douglasgoodwin/PennAnomaloscope/Electronics/PartsList_UKversion-2026-05-10.xlsx

Company | UK Stockist | Product | SKU | UK link | Notes | Item | Items in pack | Packs per anomaloscope | Cost per Item | Cost per Number of Arduinos
 |  |  |  |  |  |  |  |  |  | 1 | 2 | 3 | 4 | 5 | 6 | 7 | 8 | 9 | 10
Adafruit | thepihut.com | Diffused RGB (tri-color) 10mm LED (10 / order) | ADA848 | https://thepihut.com/products/diffused-rgb-tri-color-10mm-led-10-pack | appears to be same product | RGB LED | 10 | 0.1 | £9.60 | £9.60 | £9.60 | £9.60 | £9.60 | £9.60 | £9.60 | £9.60 | £9.60 | £9.60 | £9.60
Adafruit | thepihut.com | Diffused Yellow 10mm LED (25 / order) | ADA4204 | https://thepihut.com/products/diffused-10mm-led-pack-5-leds-each-in-5-colors-25-pack | Original product discontinued, this 25 pack incudes a good yellow | yellow LED | 25 (5x5 colours) | 0.2 | £7.70 | £7.70 | £7.70 | £7.70 | £7.70 | £7.70 | £15.40 | £15.40 | £15.40 | £15.40 | £15.40
3DQF | thepihut.com | Prusament ASA Natural 850g | PLA-009 | https://thepihut.com/products/jet-black-pla-filament-1-75mm-1kg | black filament instead | filament | 1kg | 0.1 | £18.00 | £18.00 | £18.00 | £18.00 | £18.00 | £18.00 | £18.00 | £18.00 | £18.00 | £18.00 | £18.00
Arduino | thepihut.com | Arduino Leonardo with Headers | A000057 | https://thepihut.com/products/arduino-leonardo-with-headers | same leonardo available | Leonardo | 1 | 1 | £21.20 | £21.20 | £42.40 | £63.60 | £84.80 | £106.00 | £127.20 | £148.40 | £169.60 | £190.80 | £212.00
The Pi Hut | thepihut.com | 330 Ω resistor (quarter and half watt sets) | 105395 | https://thepihut.com/products/resistor-packs-1-2-watt-1?variant=42440180662467 | 330 ohm 1/2 watt | 330 ohm resistor | 25 | 0.02 | £2.00 | £2.00 | £2.00 | £2.00 | £2.00 | £2.00 | £2.00 | £2.00 | £2.00 | £2.00 | £2.00
The Pi Hut | thepihut.com | 100 Ω resistor X 2 (quarter and half watt sets) | 105393 | https://thepihut.com/products/resistor-packs-1-2-watt-1?variant=42440180596931 | 100 ohm 1/2 | 100 ohm resistor | 25 | 0.02 | £2.00 | £2.00 | £2.00 | £2.00 | £2.00 | £2.00 | £2.00 | £2.00 | £2.00 | £2.00 | £2.00
Adafruit | thepihut.com | Hook-up Wire Spool Set - 22AWG Solid Core | 104316 | https://thepihut.com/products/prototyping-wire-spool-set-10-spool | stranded core wire not recommended for breadboard, get solid core | wire | 10 x 25ft | 0.04 | £21.90 | £21.90 | £21.90 | £21.90 | £21.90 | £21.90 | £21.90 | £21.90 | £21.90 | £21.90 | £21.90
LEE | LEE Direct | LEE 767 Oklahoma Yellow Lighting Gel | 767H | https://leefiltersdirect.com/products/lee-767-oklahoma-yellow-lighting-gel?variant=42281862103220 | LEE 767 Oklahoma Yellow Lighting Gel | yellow filter | 21" x 24" | 0.02 | £4.75 | £4.75 | £4.75 | £4.75 | £4.75 | £4.75 | £4.75 | £4.75 | £4.75 | £4.75 | £4.75
LEE | LEE Direct | Diffusion paper | 410H | https://leefiltersdirect.com/products/410-opal-frost?_pos=1&_sid=77f81dda0&_ss=r&variant=42295783456948 | LEE 410 Opal Frost Diffusion Gel - Appears very similar to the diffusion tape and diffuses the LEDs the best out of the swatch book | diffuser | 21" x 24" | 0.02 | £4.62 | £4.62 | £4.62 | £4.62 | £4.62 | £4.62 | £4.62 | £4.62 | £4.62 | £4.62 | £4.62
LEE | LEE Direct | LEE 210 .6 Neutral density filter | 210H | https://leefiltersdirect.com/products/210-6nd?_pos=2&_sid=443877e67&_ss=r&variant=42274782740660 | LEE 210 .6 Neutral Density FIlter - Dim the mixing light so can be matched with the ref. light | ND filter | 21" x 24" | 0.02 | £4.75 | £4.75 | £4.75 | £4.75 | £4.75 | £4.75 | £4.75 | £4.75 | £4.75 | £4.75 | £4.75
Adafruit | mouser.co.uk | Adafruit Proto Shield for Arduino V:R3 | 2077 | https://www.mouser.co.uk/ProductDetail/Adafruit/2077?qs=GURawfaeGuAV%252BqSx1Q3Ycw%3D%3D | sold out at thepihut, available at digikey but slow delivery | proto shield | 1 | 1 | £7.47 | £7.47 | £14.94 | £22.41 | £29.88 | £37.35 | £44.82 | £52.29 | £59.76 | £67.23 | £74.70
SEI-StackPole | mouser.co.uk | 150 Ω resistor (quarter watt and half watt sets) | CF12JT150R | https://www.mouser.co.uk/ProductDetail/SEI-Stackpole/CF12JT150R?qs=FESYatJ8odICBkpNxp%2FeFg%3D%3D | 150 ohm not stocked at thepihut, digikey has delays, found at mouser.co.uk | 150 ohm resistor | 10 | 0.1 | £1.20 | £1.20 | £1.20 | £1.20 | £1.20 | £1.20 | £1.20 | £1.20 | £1.20 | £1.20 | £1.20
Boots | Boots | Colourful elastic bands | - | https://www.boots.com/boots-kids-multi-bright-coloured-polybands-15s-10317976 | Does not need to be these, any colourful elastic bands with fabric covering are fine! | Fabric-covered elastic bands | 15 | 0.06666666667 | £2.00 | £2.00 | £2.00 | £2.00 | £2.00 | £2.00 | £2.00 | £2.00 | £2.00 | £2.00 | £2.00
UniBond | Rymans | Black electrical tape | - | https://www.ryman.co.uk/unibond-insulating-electrical-tape-pack-of-6-x-3-5m-1 | Used to secure diffuion paper to casing and to mark different Arduino devices. | Electrical Tape | 6 x 3.5m | 0.04 | £6.49 | £6.49 | £6.49 | £6.49 | £6.49 | £6.49 | £6.49 | £6.49 | £6.49 | £6.49 | £6.49
 |  |  |  |  |  |  |  |  | TOTAL COST | £113.68 | £142.35 | £171.02 | £199.69 | £228.36 | £264.73 | £293.40 | £322.07 | £350.74 | £379.41
 |  |  |  |  |  |  |  |  | COST PER UNIT | £113.68 | £71.17 | £57.01 | £49.92 | £45.67 | £44.12 | £41.91 | £40.26 | £38.97 | £37.94
