douglasgoodwin/PennAnomaloscope/(commit log)

2026-05-08 Remove video link from README
    Removed a video link demonstrating the assembly process, because the video no longer exists at the other end of the link.
2026-05-10 Contributions from Dana Turner.
    UK parts list
    Spectral measurements,.
    [PartsList_UKversion-2026-05-10.xlsx]
2026-05-23 Added an AssemblyInstructions document in CAD that has pictures illustrating the assembly steps.
2026-06-27 Add Doug/: no-MATLAB firmware + Python Rayleigh-match harness
    A host-driven take on the Penn Anomaloscope. The Arduino becomes a dumb
    actuator — raw R/G/Y over serial (9600 baud), steady field, no flicker — and
    all color math, calibration, and logging move to the host.
    - rayleigh_match.py: calibrate / adjust / limits modes (method of limits
    reports the matching-range width, the tetrachromacy signal); per-session
    CSV logging; pyserial only.
    - Calibration owned in software: G_GAIN (red/green balance) and RGB_SCALE
    (mix vs. yellow), set by eye in `calibrate`, with a DVD-grating quick check
    and a path to spectral calibration.
    - Color-filter guidance: orange long-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
